web4upl/hydro/schemat copy.jpg

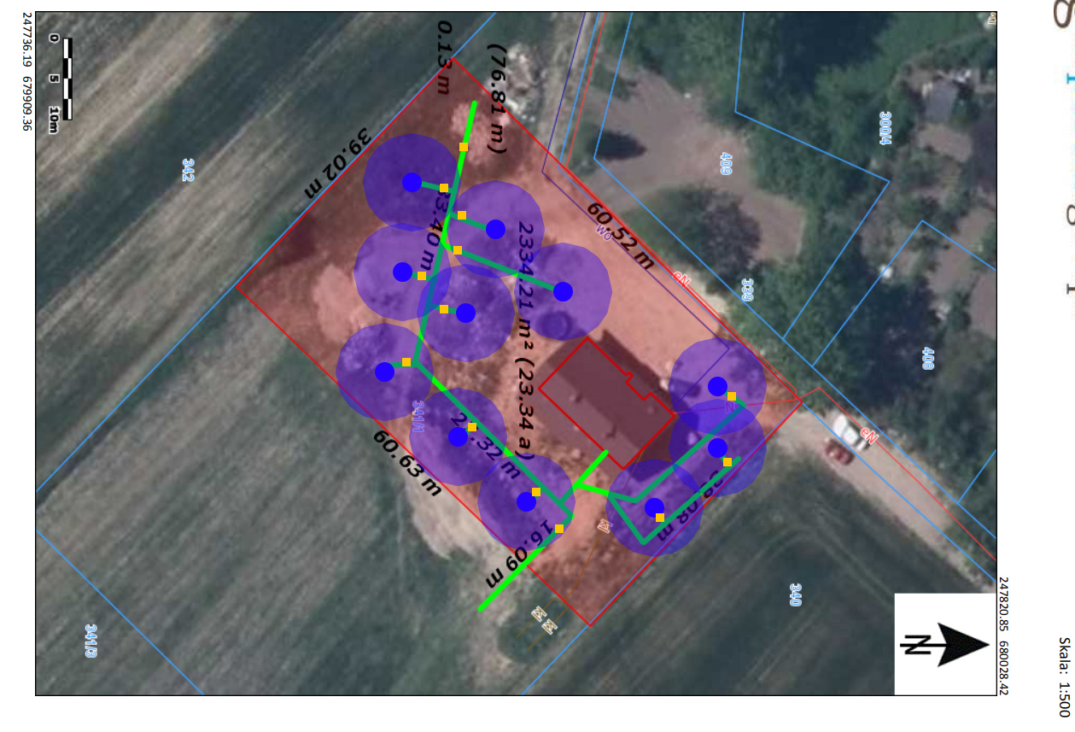
schemat copy.jpg
