web4upl/hydro/schemat-woda-zasilanie copy.jpg

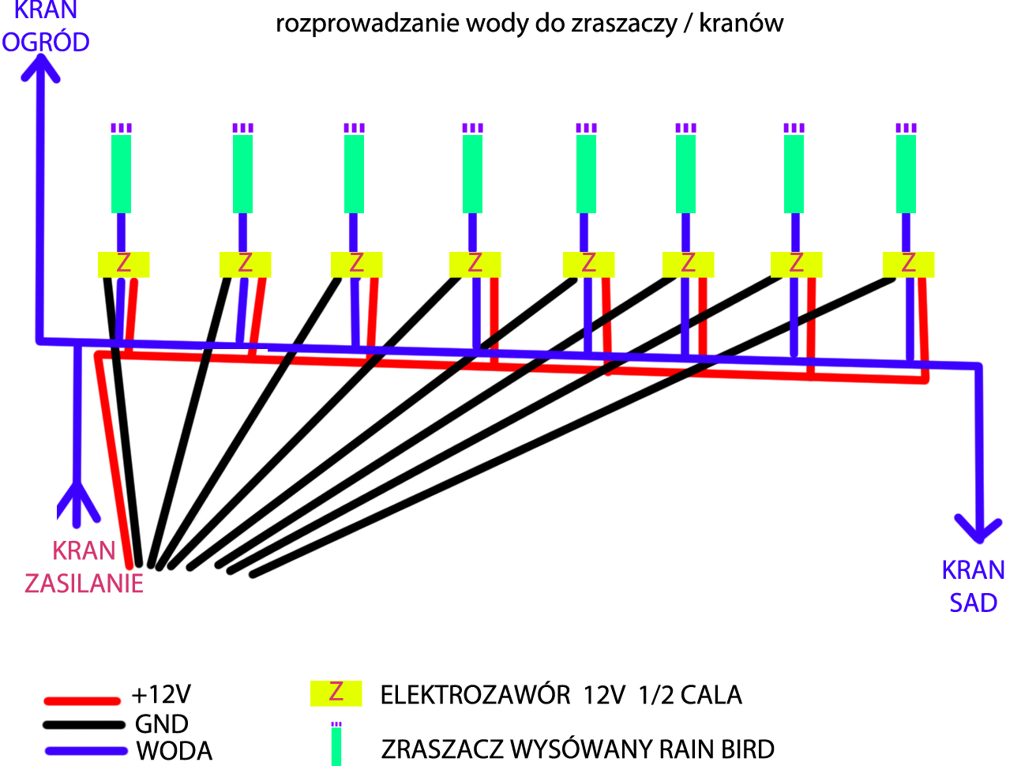
schemat-woda-zasilanie copy.jpg
